nistunedev/AmstradPCWKeyboard/(commit log)

2026-06-27 Create branch from original XT emulator for PCW keyboard emulation
    Add PCW8256 diagnostic frame-transmitter mode on top of XT-derived firmware; Refactor XT-derived keyboard firmware into PCW8256 state-frame emulator with diagnostic modes
2026-07-09 Refocus documentation on PCW8256 emulator
    Replace inherited XT and PC1512 documentation with PCW8256 development, testing, and tool information. Document the active firmware and KEYTEST diagnostic, credit Pasmo and iDSK, and remove the obsolete legacy AmstradXTPS2 sketch.
    [PCW8256_PS2_Keyboard_Emulator.ino]
2026-07-09 Fix PCW protocol and diagnostic workflow
    [PCW8256_PS2_Keyboard_Emulator.ino]
2026-07-10 Interim checking
    Added James logic analysis covering timing specifics; Get codex to update the interrupts with close timing and data transitions;
    Added protocol handover for claude to try; We are not seeing 48uS high cycle on 4th clock for each frame; we do have correct interframe timing; Current clock low is 10uS and high 18uS on the analyser
    Pins should be output and with 47K pull up on keyboard side before 470 ohm resistor
    Updated readme with useful info
    [PCW8256_PS2_Keyboard_Emulator.ino]
2026-07-11 Fix PCW clock timing and add transmitter diagnostics
    Clock generation:
    - Time each interval off the Timer1 CTC compare match (set OCR1A only)
    instead of zeroing TCNT1 mid-ISR, so pulse widths no longer absorb the
    ISR's own run time. Fixes the inflated/stretched low periods.
    - Rewrite the transmitter ISR to a two-phase-per-bit state machine
    (RaiseClock/LowerClock) that toggles CLK as its first action, removing
    the per-bit jitter.
    - Add PCW_INVERT_CLK to select physical CLK polarity (default 0 matches
    the real keyboard's 12us-high/21us-low on the current rig).
    - Move the per-word skip to suppress only D3's rising edge; the D6 mirror
    now pulses uniformly on every bit as a no-skip re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
    [PCW8256_PS2_Keyboard_Emulator.ino]
2026-07-11 Update reference images: schematic with pull-ups, frame-zoom captures
    - schematic.png: revised to include the PCW keyboard and the series +
    pull-up resistors on the CLK/DATA lines.
    - Add logic-analyser WORD0 captures: "PCW James Logic frame1 highlighted"
    (frame boundary) and "...frame1 zoomed" (start-of-frame detail), used
    for decoding the data/clock alignment.
    - Add "PCW keyboard connector resistors" reference for the resistor values.
    - Remove superseded images: "PCW Keyboard matrix 1" and
    "PCW-side-keyboard-header".
2026-07-11 Switch to full-emulator mode; document validated status in README
    - Default build to DIAG_FULL_EMULATOR (reads PS/2, updates matrix, rebuilds
    frame) and DIAG_DISABLE_TIMER0_IRQ=0 (keep millis()/micros() for the PS/2
    library); clarify in the flag comment not to disable Timer0 in a mode that
    reads the keyboard.
    - README: add a Development Status section recording what has been validated
    on the logic analyser (clock waveform, 17-word frame structure, offset
    sequence, toggle/transmitting flags, DATA/CLK alignment, and the end-to-end
    A-key path setting byte 0x08 bit 5), the diagnostic build flags, and the
    open items (real-PCW KEYTEST for polarity confirmation, and the ~32 ms
    trans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
2026-07-11 Add reference images throughout the README
    Place the images/ pictures into their matching sections: intro keyboard gif,
    PS/2 connector, logic-analyser frame captures in Development Status, service-
    manual and memory-map matrices, control-status matrix, connector pinout,
    input-to-ASIC and connector-resistor detail plus the emulator schematic in the
    hardware-connection section, and James's clock-signal analysis. Filenames with
    spaces are URL-encoded so they render on GitHub.
2026-07-11 Constrain connector-resistor image height in README
    Render the tall (822x1303) connector-resistor image via an HTML <img> tag with
    height=500 so it doesn't dominate the page.
2026-07-11 Scale connector and service-manual matrix images in README
    Connector pinout to half height (330px) and the service-manual keyboard matrix
    to three-quarter height (748px) via HTML <img> tags.
2026-07-11 Add convention-sweep handoff; real-PCW signalling WIP
    The transmitter is analyser-verified but the real PCW shows garbage — a
    signalling-convention mismatch (idle level, data/clock polarity, per-word
    sync), not a framing bug. Its receive path is alive (our transmission
    changes the display), but no keyboard is available as a reference and
    KEYTEST can't launch (phantom keys abort PROFILE.SUB).
    Firmware WIP toward the real machine:
    - Idle lines high between frames (PCW_IDLE_HIGH), matching the documented
    "lines high by default / no keyboard = all zero".
    - Invert DATA sense (PCW_INVERT_DATA): high line = 0.
    - Rework the per-word marker: send all 12 pulses and stretch the low after
    the 4th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
    [PCW8256_PS2_Keyboard_Emulator.ino]
2026-07-11 Handoff: 48us-gap frame proven correct on analyser, PCW still garbages
    PCW7-boot.vcd confirms the emitted frame is completely correct (consistent
    204 edges/frame, DATA-inverted decode = valid all-zeros no-keys frame with
    right offset sequence and flag/link bytes, waveform matches James). So every
    documented aspect is matched yet the real PCW still garbages.
    Add two untested sweep dimensions: clock polarity (never tried; couples with
    idle level) and the DATA double-toggle before each word (documented but never
    sent — a likely per-word sync for this gate array).
2026-07-11 Protocol handoff: document the per-word DATA double-toggle
    Add John Elliott's note that the real keyboard toggles DATA twice before each
    word (which we have never sent), flagged as a leading suspect now that the
    emitted frame is analyser-proven correct yet the real PCW still garbages.
    Refresh the Validation State to reflect the real-hardware result and the two
    remaining untested conventions (DATA double-toggle, clock polarity).
2026-07-11 Functional PCW protocol update
    Confirmed PCW accepts idle matrix after natural DATA polarity, low inter-frame idle, and two full DATA pre-word pulses. Active key issues remain: repeated characters and suspected stuck Up, square bracket, and Q inputs require follow-up mapping/state investigation.
    [PCW8256_PS2_Keyboard_Emulator.ino]
2026-07-11 Update KEYTEST latch diagnostic
    Latch keyboard bytes across the refresh delay so short key pulses are visible, pad KEYTEST.COM to a 1024-byte CP/M record boundary, and switch the build flow to the safe cpm_transfer/PIP workflow instead of iDSK writes. Update the KEYTEST boot disk with the refreshed diagnostic.
2026-07-12 Interim checkin
    Arduino data and clock timing fixes. Stable keyboard idle. Keyboard responds to PS2 commands but suffers from delayed repeat about 15 x per character
    [PCW8256_PS2_Keyboard_Emulator.ino]
2026-07-12 Checkpoint: clean clock/data timing baseline before state-machine rewrite
    Focus on a clean, deterministic transmitter waveform ahead of the planned
    tick-based sequencer rewrite:
    - Disable the per-word DATA preamble (DIAG_DISABLE_WORD_PREAMBLE=1) so the ISR
    no longer busy-waits (delayMicroseconds) inside the interrupt handler. The
    output is now just the 2-phase clock (12us high / 21us low, 48us after bit 3)
    with DATA loaded at the rising edge - no transient non-data DATA toggling.
    - Keeps the dropped-break keepalive auto-release (releaseStuckKeys) added this
    session; typematic override reverted (it flooded the PS/2 bus).
    Known/accepted at this checkpoint: with the preamble off the P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
    [PCW8256_PS2_Keyboard_Emulator.ino]
2026-07-12 Add handoff for the tick-based transmitter state-machine rewrite
    Captures the committed clean-timing baseline (06a0922), why we're rewriting
    (busy-wait-in-ISR / PS2-vs-waveform conflict), the target uniform-6us-tick
    design (frame/word/clock hierarchy), open items to resolve (17-word count,
    PS2 masking, 144us inter-word gap, 4th-pulse long low, grid quantization),
    suggested execution phases, and which current code to reuse vs replace.
2026-07-12 Handoff: lock in the 6 rewrite decisions + RAM constraint
    Fold the user's confirmed answers into the tick-based-sequencer handoff so
    Codex can build to them: 17 words; PS/2 masked during transmit (poll in the
    gap); 144us inter-word gap is real (James); 4th pulse extends the low by
    OMITTING its high edge; clock low = 24us on the 6us grid for now; inter-frame
    gap stays inside the 6us tick state machine (no long timer). Also flag ~96%
    SRAM usage - keyLastMakeMs[127] must be shrunk in the rewrite.
2026-07-12 Rewrite PCW transmitter as fixed tick state machine
    Implement the first Timer1 fixed-tick PCW transmit state machine update with direct-port ISR timing for the PCW keyboard protocol.
    Known remaining PS/2 keyboard issues: key presses may not respond, held keys may eventually register and then repeat by themselves, and one timing glitch showed M] after a keypress.
    [PCW8256_PS2_Keyboard_Emulator.ino]
2026-07-12 Remove obsolete PCW transmitter diagnostics
    Remove old timing bypasses and startup idle delay now that the fixed-tick state machine is the active path. Keep only the three operating modes and preserve the full-emulator PS/2/Timer0 masking policy.
    [PCW8256_PS2_Keyboard_Emulator.ino]
2026-07-12 Inhibit PS2 during PCW transmit
    Hold PS/2 clock low while PCW frames are actively transmitted, release it during inter-frame idle, and defer the next PCW frame until the PS/2 bus has been quiet. This preserves the clean PCW waveform while preventing missed PS/2 make/break events.
    [PCW8256_PS2_Keyboard_Emulator.ino]
2026-07-12 Mainly working emulator commit
    We have changed to a pure state driven machine with 6uS interrrupts and then inside the interrupt disabling the PS2 clock whilst inside (when the PS2 mask is disabled). That then allows PS2 interrupts to be captured (where previously missed whilst sending updates to the PCW)
    There are some key mapping issues also fixed, which are mostly resolved but still working out some gremlins
    [PCW8256_PS2_Keyboard_Emulator.ino]
2026-07-12 Fix comma and backslash key mappings
    - Comma (unshifted): remap to PCW apostrophe-position key with an injected
    synthetic Shift so the PCW produces ','. Shifted comma ('<') keeps its
    real-Shift + POUND path unchanged. Synthetic Shift is ref-counted through
    holdCount[PCW_KEY_SHIFT] via a new applyKeyRefCounted() helper so it
    composes with a real Shift press.
    - Backslash key: map to PCW_KEY_SLASH (was PCW_KEY_HASH); '|' follows from the
    forwarded real Shift. PCW has no dedicated backslash/pipe key, so this key
    is parked on the slash position for now.
    [PCW8256_PS2_Keyboard_Emulator.ino]
